Eniemooo/Sensor-HAT/docs/Sensor-HAT-3D-bottom.png

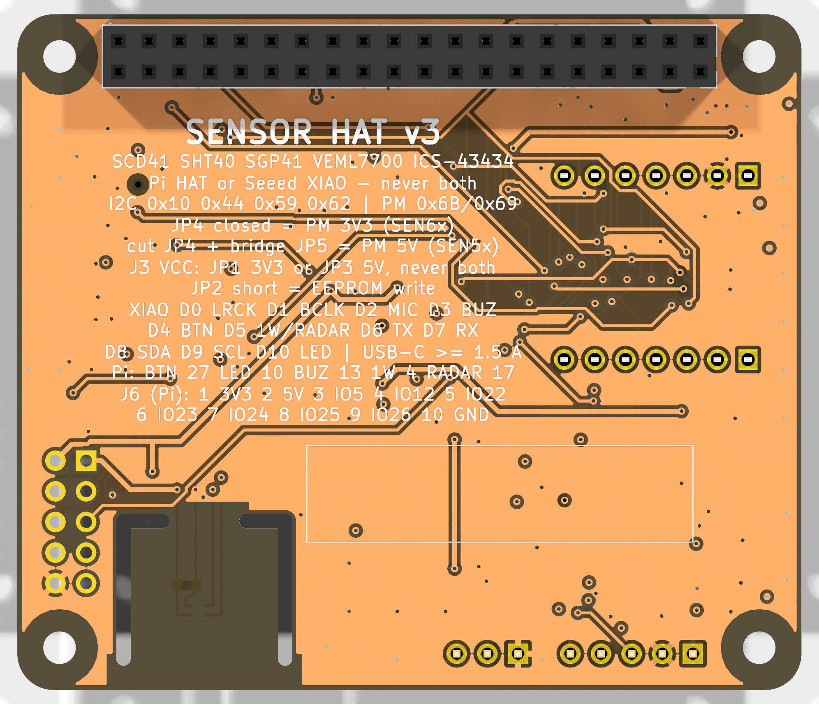
docs/Sensor-HAT-3D-bottom.png
