Eniemooo/Sensor-HAT/docs/Sensor-HAT-3D-top.png

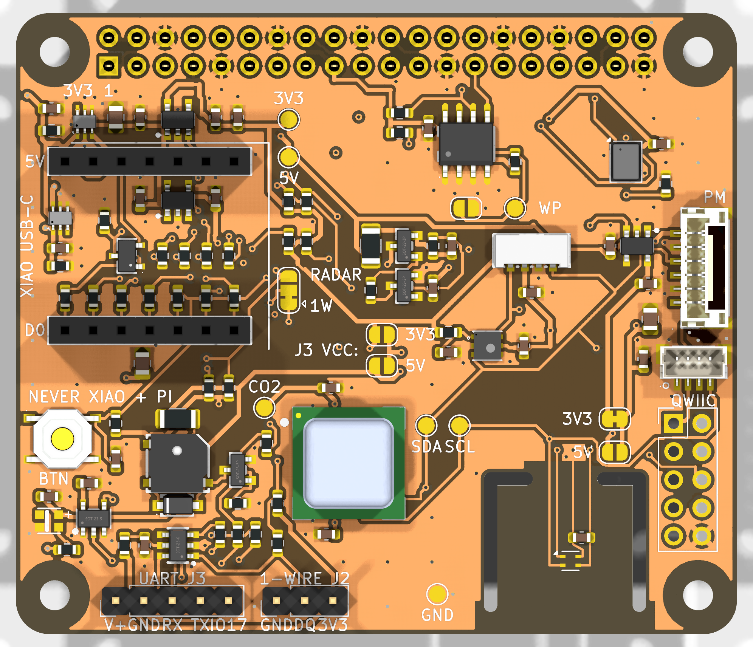
docs/Sensor-HAT-3D-top.png
