Eniemooo/Sensor-HAT/production/Sensor-HAT-BOM-jlcpcb-komplett.csv

Comment | Designator | Footprint | LCSC Part # | Quantity | Manufacturer | MPN
AP2112K-3.3 | U5,U6,U9 | SOT-25-5_L2.9-W1.6-P0.95-LS2.8-BL | C51118 | 3 | Diodes | AP2112K-3.3TRG1
10uF 25V | C11,C12 | C_0805_2012Metric | C15850 | 2 | Samsung | CL21A106KAYNNNE
1uF | C1,C2,C3,C14,C15,C17,C18,C27,C28,C29,C30,C31 | C_0603_1608Metric | C15849 | 12 | Samsung | CL10A105KB8NNNC
10uF | C4,C13 | C_0603_1608Metric | C19702 | 2 | Samsung | CL10A106KP8NNNC
BAV70 | D3 | SOT-23-3_L3.0-W1.7-P0.95-LS2.9-BR | C68978 | 1 | CJ | BAV70
LM66100 | U14,U15 | SC-70-6_L2.0-W1.3-P0.65-LS2.1-BL | C2869734 | 2 | TI | LM66100DCKR
100k | R4,R7,R11,R13,R14,R23,R29,R30,R32 | R_0603_1608Metric | C25803 | 9 | UNI-ROYAL | 0603WAF1003T5E
SCD41-D-R2 | U1 | LGA-20_L10.1-W10.1-P1.25-TL_SCD41-D-R2 | C3659294 | 1 | Sensirion | SCD41-D-R2
100nF | C5,C6,C8,C9,C10,C16,C20,C23,C24,C26 | C_0603_1608Metric | C14663 | 10 | YAGEO | CC0603KRX7R9BB104
SHT40 | U2 | SHT4x_DFN-4_1.5x1.5mm_P0.8mm_NoCentralPad | C2909890 | 1 | Sensirion | SHT40-AD1B-R2
SGP41 | U13 | DFN-6_L2.4-W2.4-P0.80-TL-EP | C3659325 | 1 | Sensirion | SGP41-D-R4
4.7 | R28 | R_0603_1608Metric | C23164 | 1 | UNI-ROYAL | 0603WAF470KT5E
VEML7700-TT | U7 | SENSOR-SMD_EML7700-TT | C1850416 | 1 | Vishay | VEML7700-TT
ICS-43434 | U3 | InvenSense_ICS-43434-6_3.5x2.65mm | C5656610 | 1 | TDK InvenSense | ICS-43434
CAT24C32 | U4 | SOIC-8_L5.0-W4.0-P1.27-LS6.0-BL | C81193 | 1 | onsemi | CAT24C32WI-GT3
3.9k | R2,R3 | R_0603_1608Metric | C23018 | 2 | UNI-ROYAL | 0603WAF3901T5E
1k | R5,R8,R9,R10 | R_0603_1608Metric | C21190 | 4 | UNI-ROYAL | 0603WAF1001T5E
1-Wire GND/DQ/3V3 | J2 | PinHeader_1x03_P2.54mm_Vertical | C49257 | 1 | BOOMELE | 2.54-1*3P
4.7k | R1,R26,R27 | R_0603_1608Metric | C23162 | 3 | UNI-ROYAL | 0603WAF4701T5E
100 | R16,R20,R22,R33,R34,R35,R36,R37,R38,R39,R40,R41,R42,R43 | R_0603_1608Metric | C22775 | 14 | UNI-ROYAL | 0603WAF1000T5E
UART (e.g. PMS5003) | J3 | PinHeader_1x05_P2.54mm_Vertical | C32713271 | 1 | hanxia | HX PZ2.54-1x5P ZZ
10k | R12,R15,R19,R31 | R_0603_1608Metric | C25804 | 4 | UNI-ROYAL | 0603WAF1002T5E
SRV05-4 | U8 | SOT-23-6_L2.9-W1.6-P0.95-LS2.8-BR | C85364 | 1 | ProTek Devices | SRV05-4-P-T7
0.5A PTC | F1 | Fuse_1206_3216Metric | C70077 | 1 | TECHFUSE | nSMD050-33V
AO3401A | Q1 | SOT-23_L2.9-W1.3-P1.90-LS2.4-BR | C15127 | 1 | Alpha & Omega | AO3401A
AO3400A | Q2,Q3 | SOT-23_L2.9-W1.3-P1.90-LS2.4-BR | C20917 | 2 | Alpha & Omega | AO3400A
22uF 25V | C19 | C_0805_2012Metric | C45783 | 1 | Samsung | CL21A226MAQNNNE
PM sensor (SEN6x/SEN5x) | J4 | CONN-SMD_6P-P1.25_BM06B-GHS-TBT-LF-SN-N | C189892 | 1 | JST | BM06B-GHS-TBT(LF)(SN)
Qwiic / STEMMA QT | J5 | CONN-SMD_BM04B-SRSS-TB | C160390 | 1 | JST | BM04B-SRSS-TB(LF)(SN)
Button | SW1 | SW-SMD_4P-L5.1-W5.1-P3.70-LS6.5-TL_H1.5 | C318884 | 1 | XKB | TS-1187A-B-A-B
74LV1T125 | U12 | SOT-23-5_L3.0-W1.7-P0.95-LS2.8-BL | C473338 | 1 | TI | SN74LV1T125DBVR
WS2812B-2020 | D1 | LED-SMD_4P-L2.2-W2.0-P1.00_WS2815C-2020-4P | C52917434 | 1 | Worldsemi | WS2812B-2020-V6
MLT-5020 4kHz | LS1 | BUZ-SMD_L5.0-W5.5-P4.60 | C94598 | 1 | Huaneng | MLT-5020
33 0.5W 1206 | R21 | R_1206_3216Metric | C5713420 | 1 | FOJAN | FRP1206F33R0TS
1N4148W | D2 | SOD-123F_L2.7-W1.6-LS3.8-RD | C81598 | 1 | ST | 1N4148W
XIAO D0-D6 | J7,J8 | HDR-TH_7P-P2.54-V-F | C2897370 | 2 | HCTL | PM254-1-07-Z-8.5
