Eniemooo/Sensor-HAT/docs/Sensor-HAT-Bestueckung-oben.pdf

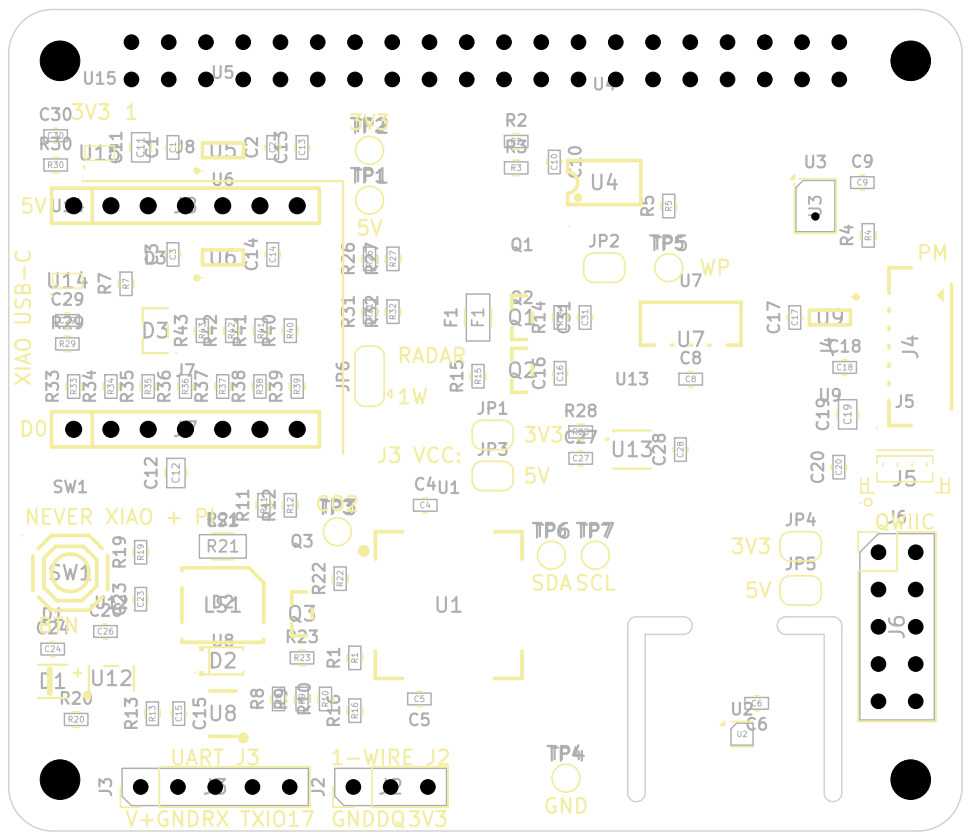
[picture p4: page 1]

Emanuel Bachmann
Sheet:
File: Sensor-HAT.kicad_pcb
Title: Sensor HAT v3 Universal (for Raspberry Pi or Seeed XIAO)

Size: A3 | Rev: 3.0 | F Date: 2026-10-22
KiCad E.D.A. 10.0.7 | Id: 1/1
