Eniemooo/Sensor-HAT/docs/Sensor-HAT-Bestueckung-unten.pdf

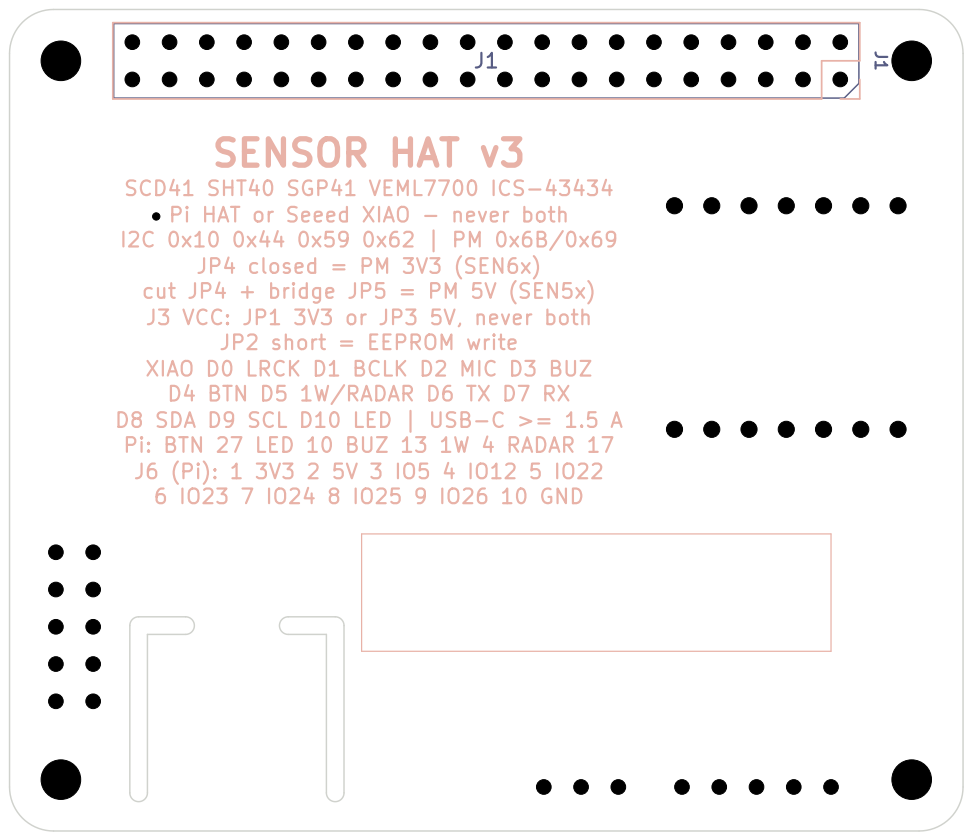
[picture p5: page 1]

6 IO23 7 IO24 8 IO25 9 IO26 10 GND SENSOR HAT v3
SCD41 SHT40 SGP41 VEML7700 ICS-43434 Pi HAT or Seeed XIAO - never both

JP4 closed = PM 3V3 (SEN6x) cut JP4 + bridge JP5 = PM 5V (SEN5x) J3 VCC: JP1 3V3 or JP3 5V, never both

JP2 short = EEPROM write XIAO D0 LRCK D1 BCLK D2 MIC D3 BUZ D4 BTN D5 1W/RADAR D6 TX D7 RX D8 SDA D9 SCL D10 LED | USB-C >= 1.5 A Pi: BTN 27 LED 10 BUZ 13 1W 4 RADAR 17

Sheet:
File: Sensor-HAT.kicad_pcb
Title: Sensor HAT v3 Universal (for Raspberry Pi or Seeed XIAO)

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
