Eniemooo/Sensor-HAT/docs/Sensor-HAT-Schaltplan.pdf

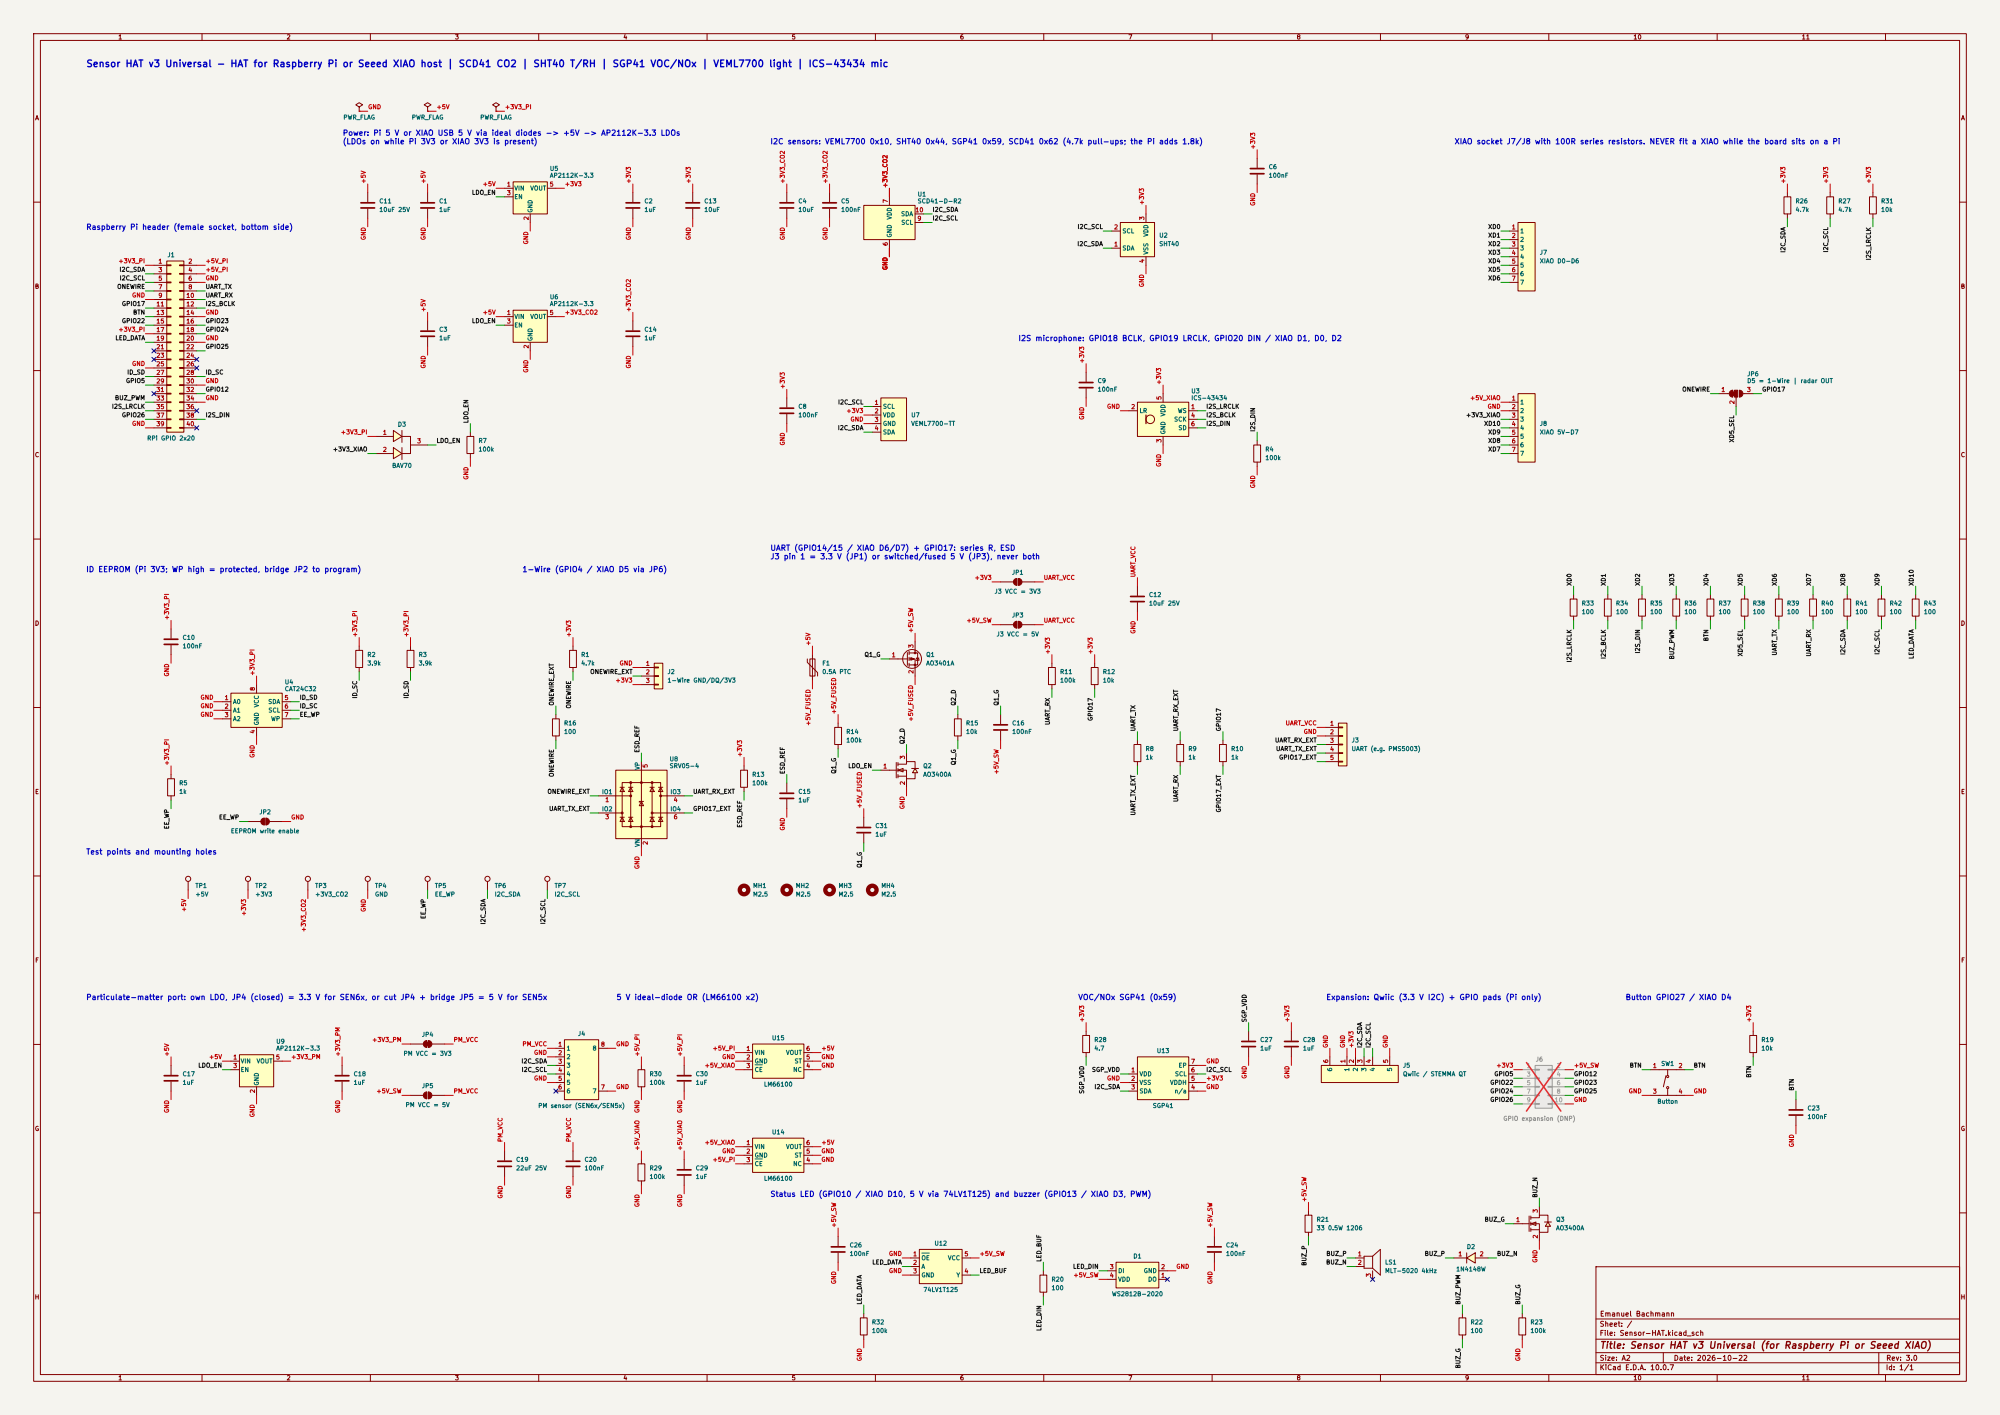
[picture p6: page 1]

Sensor HAT v3 Universal - HAT for Raspberry Pi or Seeed XIAO host | SCD41 CO2 | SHT40 T/RH | SGP41 VOC/NOx | VEML7700 light | ICS-43434 mic

Power: Pi 5 V or XIAO USB 5 V via ideal diodes -> +5V -> AP2112K-3.3 LDOs
(LDOs on while Pi 3V3 or XIAO 3V3 is present)

Raspberry Pi header (female socket, bottom side)
J1 RPi GPIO 2x20

I2S microphone: GPIO18 BCLK, GPIO19 LRCLK, GPIO20 DIN / XIAO D1, D0, D2

UART (GPIO14/15 / XIAO D6/D7) + GPIO17: series R, ESD
J3 pin 1 = 3.3 V (JP1) or switched/fused 5 V (JP3), never both

ID EEPROM (Pi 3V3; WP high = protected, bridge JP2 to program)

Test points and mounting holes

Expansion: Qwiic (3.3 V I2C) + GPIO pads (Pi only)

Status LED (GPIO10 / XIAO D10, 5 V via 74LV1T125) and buzzer (GPIO13 / XIAO D3, PWM)

Emanuel Bachmann
Sheet: /
File: Sensor-HAT.kicad_sch
Title: Sensor HAT v3 Universal (for Raspberry Pi or Seeed XIAO)

Size: A2 | Rev: 3.0
KiCad E.D.A. 10.0.7 | Id: 1/1
