Eniemooo/Sensor-HAT/Sensor-HAT.kicad_pcb

## KiCad design Sensor-HAT.kicad_pcb (2026-10-27)

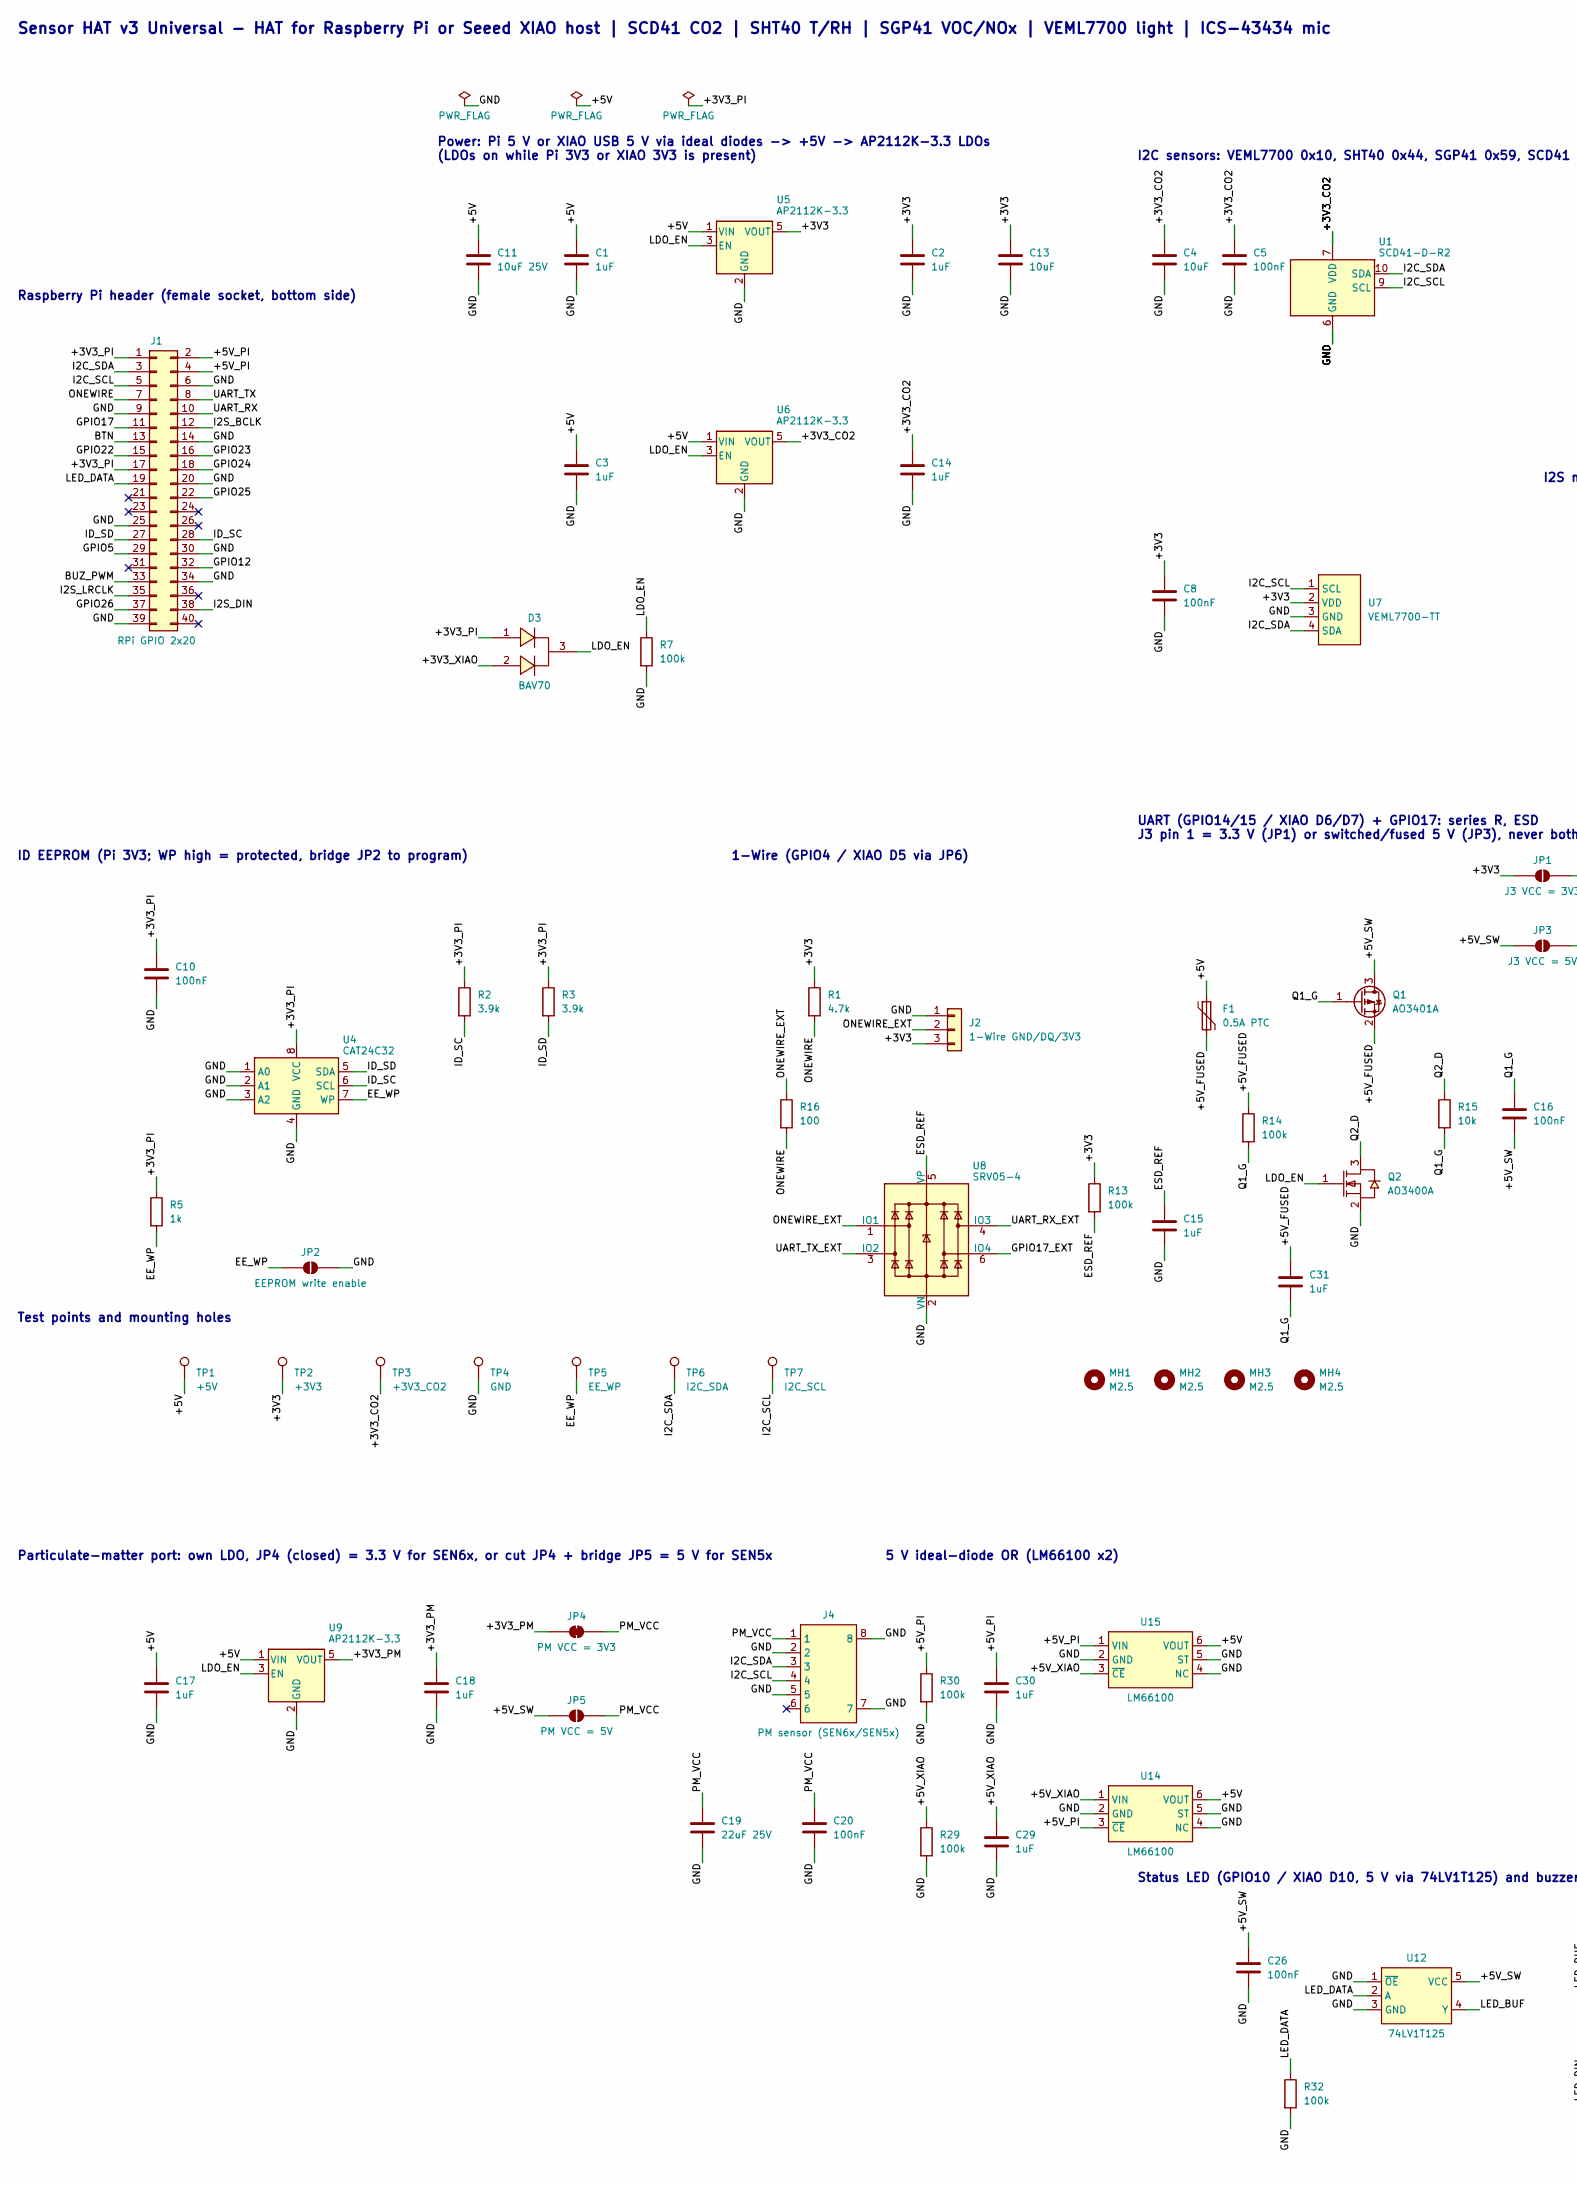
[picture p7: schematic Sensor-HAT.kicad_sch, Sensor HAT v3 Universal (for Raspberry Pi or Seeed XIAO), part in row 1, column 1]

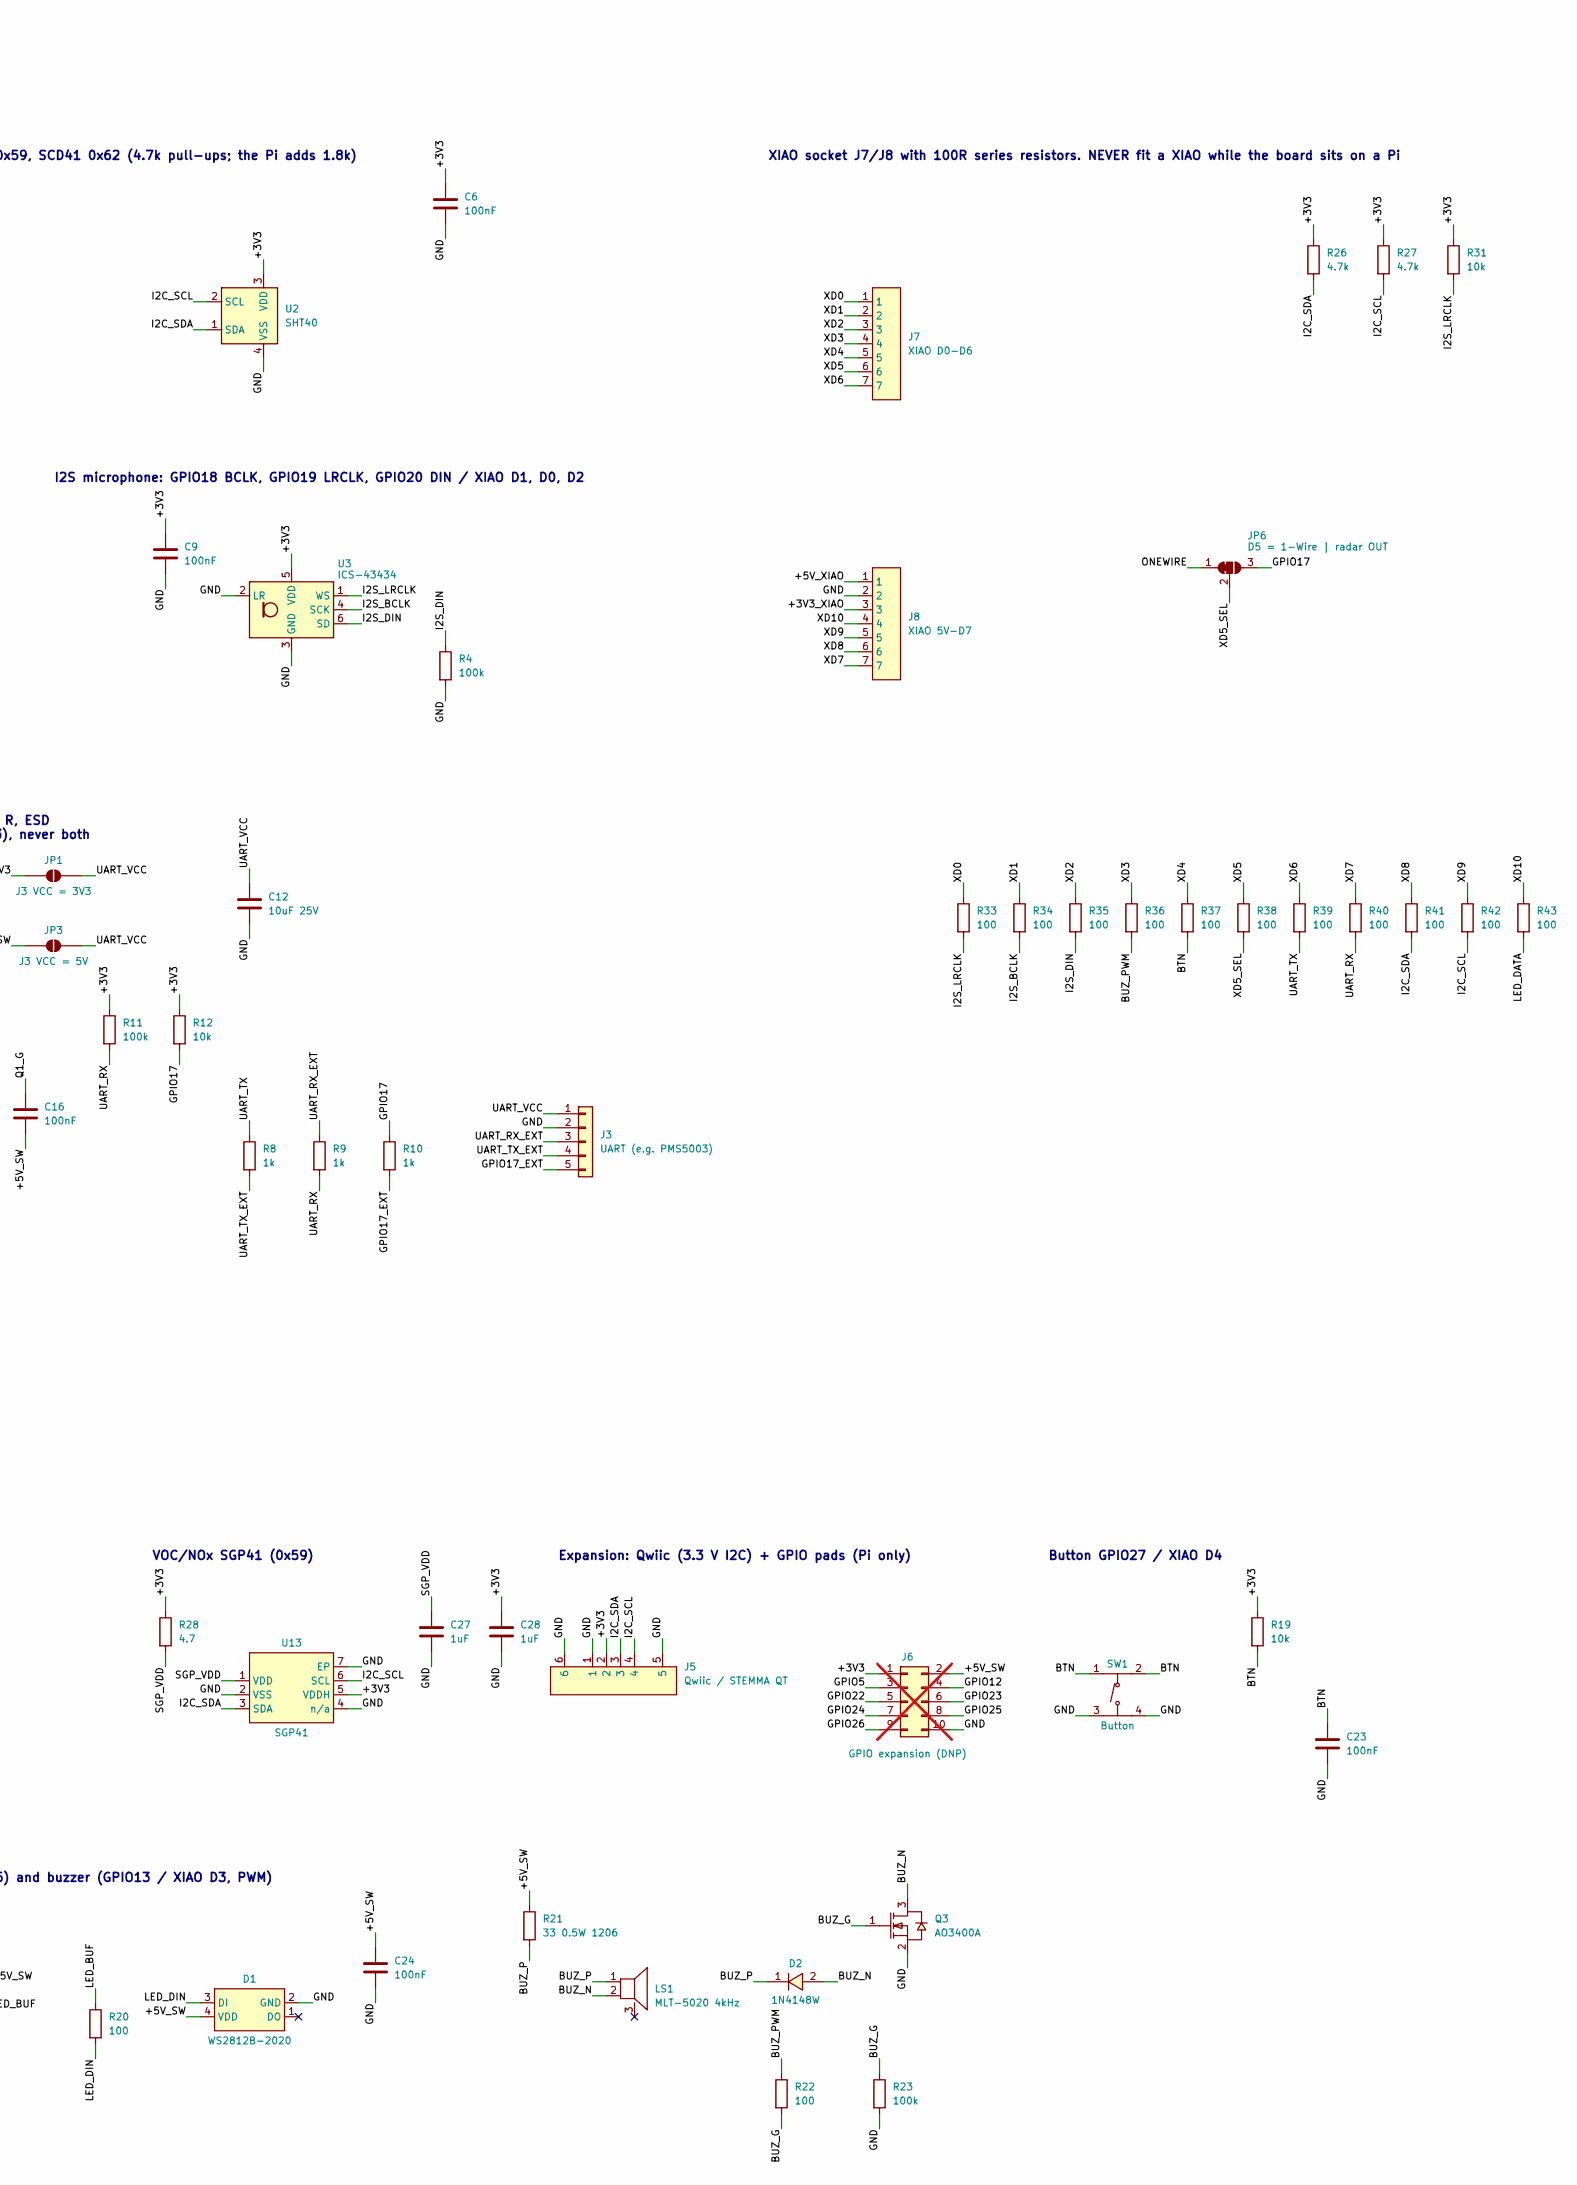
[picture p8: schematic Sensor-HAT.kicad_sch, Sensor HAT v3 Universal (for Raspberry Pi or Seeed XIAO), part in row 1, column 2]

Parts:
C1, C2, C3, C14, C15, C17, C18, C27, C28, C29, C30, C31: 1uF; C_0603_1608Metric; MPN CL10A105KB8NNNC; LCSC C15849
C4, C13: 10uF; C_0603_1608Metric; MPN CL10A106KP8NNNC; LCSC C19702
C5, C6, C8, C9, C10, C16, C20, C23, C24, C26: 100nF; C_0603_1608Metric; MPN CC0603KRX7R9BB104; LCSC C14663
C11, C12: 10uF 25V; C_0805_2012Metric; MPN CL21A106KAYNNNE; LCSC C15850
C19: 22uF 25V; C_0805_2012Metric; MPN CL21A226MAQNNNE; LCSC C45783
D1: WS2812B-2020; LED-SMD_4P-L2.2-W2.0-P1.00_WS2815C-2020-4P; MPN WS2812B-2020-V6; LCSC C52917434
D2: 1N4148W; SOD-123F_L2.7-W1.6-LS3.8-RD; MPN 1N4148W; LCSC C81598
D3: BAV70; SOT-23-3_L3.0-W1.7-P0.95-LS2.9-BR; MPN BAV70; LCSC C68978
F1: 0.5A PTC; Fuse_1206_3216Metric; MPN nSMD050-33V; LCSC C70077
J1: RPi GPIO 2x20; PinSocket_2x20_P2.54mm_Vertical; MPN 2.54-2*20; LCSC C2977589
J2: 1-Wire GND/DQ/3V3; PinHeader_1x03_P2.54mm_Vertical; MPN 2.54-1*3P; LCSC C49257
J3: UART (e.g. PMS5003); PinHeader_1x05_P2.54mm_Vertical; MPN HX PZ2.54-1x5P ZZ; LCSC C32713271
J4: PM sensor (SEN6x/SEN5x); CONN-SMD_6P-P1.25_BM06B-GHS-TBT-LF-SN-N; MPN BM06B-GHS-TBT(LF)(SN); LCSC C189892
J5: Qwiic / STEMMA QT; CONN-SMD_BM04B-SRSS-TB; MPN BM04B-SRSS-TB(LF)(SN); LCSC C160390
J6: GPIO expansion (DNP); PinHeader_2x05_P2.54mm_Vertical; not fitted
J7: XIAO D0-D6; HDR-TH_7P-P2.54-V-F; MPN PM254-1-07-Z-8.5; LCSC C2897370
J8: XIAO 5V-D7; HDR-TH_7P-P2.54-V-F; MPN PM254-1-07-Z-8.5; LCSC C2897370
JP1: J3 VCC = 3V3; SolderJumper-2_P1.3mm_Open_RoundedPad1.0x1.5mm
JP2: EEPROM write enable; SolderJumper-2_P1.3mm_Open_RoundedPad1.0x1.5mm
JP3: J3 VCC = 5V; SolderJumper-2_P1.3mm_Open_RoundedPad1.0x1.5mm
JP4: PM VCC = 3V3; SolderJumper-2_P1.3mm_Bridged_RoundedPad1.0x1.5mm
JP5: PM VCC = 5V; SolderJumper-2_P1.3mm_Open_RoundedPad1.0x1.5mm
JP6: D5 = 1-Wire | radar OUT; SolderJumper-3_P1.3mm_Bridged12_RoundedPad1.0x1.5mm
LS1: MLT-5020 4kHz; BUZ-SMD_L5.0-W5.5-P4.60; MPN MLT-5020; LCSC C94598
MH1, MH2, MH3, MH4: M2.5; MountingHole_2.7mm_M2.5
Q1: AO3401A; SOT-23_L2.9-W1.3-P1.90-LS2.4-BR; MPN AO3401A; LCSC C15127
Q2, Q3: AO3400A; SOT-23_L2.9-W1.3-P1.90-LS2.4-BR; MPN AO3400A; LCSC C20917
R1, R26, R27: 4.7k; R_0603_1608Metric; MPN 0603WAF4701T5E; LCSC C23162
R2, R3: 3.9k; R_0603_1608Metric; MPN 0603WAF3901T5E; LCSC C23018
R4, R7, R11, R13, R14, R23, R29, R30, R32: 100k; R_0603_1608Metric; MPN 0603WAF1003T5E; LCSC C25803
R5, R8, R9, R10: 1k; R_0603_1608Metric; MPN 0603WAF1001T5E; LCSC C21190
R12, R15, R19, R31: 10k; R_0603_1608Metric; MPN 0603WAF1002T5E; LCSC C25804
R16, R20, R22, R33, R34, R35, R36, R37, R38, R39, R40, R41, R42, R43: 100; R_0603_1608Metric; MPN 0603WAF1000T5E; LCSC C22775
R21: 33 0.5W 1206; R_1206_3216Metric; MPN FRP1206F33R0TS; LCSC C5713420
R28: 4.7; R_0603_1608Metric; MPN 0603WAF470KT5E; LCSC C23164
SW1: Button; SW-SMD_4P-L5.1-W5.1-P3.70-LS6.5-TL_H1.5; MPN TS-1187A-B-A-B; LCSC C318884
TP1: +5V; TestPoint_Pad_D1.5mm
TP2: +3V3; TestPoint_Pad_D1.5mm
TP3: +3V3_CO2; TestPoint_Pad_D1.5mm
TP4: GND; TestPoint_Pad_D1.5mm
TP5: EE_WP; TestPoint_Pad_D1.5mm
TP6: I2C_SDA; TestPoint_Pad_D1.5mm
TP7: I2C_SCL; TestPoint_Pad_D1.5mm
U1: SCD41-D-R2; LGA-20_L10.1-W10.1-P1.25-TL_SCD41-D-R2; MPN SCD41-D-R2; LCSC C3659294
U2: SHT40; SHT4x_DFN-4_1.5x1.5mm_P0.8mm_NoCentralPad; MPN SHT40-AD1B-R2; LCSC C2909890
U3: ICS-43434; InvenSense_ICS-43434-6_3.5x2.65mm; MPN ICS-43434; LCSC C5656610
U4: CAT24C32; SOIC-8_L5.0-W4.0-P1.27-LS6.0-BL; MPN CAT24C32WI-GT3; LCSC C81193
U5, U6, U9: AP2112K-3.3; SOT-25-5_L2.9-W1.6-P0.95-LS2.8-BL; MPN AP2112K-3.3TRG1; LCSC C51118
U7: VEML7700-TT; SENSOR-SMD_EML7700-TT; MPN VEML7700-TT; LCSC C1850416
U8: SRV05-4; SOT-23-6_L2.9-W1.6-P0.95-LS2.8-BR; MPN SRV05-4-P-T7; LCSC C85364
U12: 74LV1T125; SOT-23-5_L3.0-W1.7-P0.95-LS2.8-BL; MPN SN74LV1T125DBVR; LCSC C473338
U13: SGP41; DFN-6_L2.4-W2.4-P0.80-TL-EP; MPN SGP41-D-R4; LCSC C3659325
U14, U15: LM66100; SC-70-6_L2.0-W1.3-P0.65-LS2.1-BL; MPN LM66100DCKR; LCSC C2869734

Connections:
/+3V3: C2.1, C6.1, C8.1, C9.1, C13.1, C28.1, J2.3, J5.2, J6.1, JP1.1 (A), R1.1, R11.1, R12.1, R13.1, R19.1, R26.1, R27.1, R28.1, R31.1, TP2.1, U2.3 (VDD), U3.5 (VDD), U5.5 (VOUT), U7.2 (VDD), U13.5 (VDDH)
/+3V3_CO2: C4.1, C5.1, C14.1, TP3.1, U1.7 (VDD), U1.19 (VDD), U6.5 (VOUT)
/+3V3_PI: C10.1, D3.1, J1.1, J1.17, R2.1, R3.1, R5.1, U4.8 (VCC)
/+3V3_PM: C18.1, JP4.1 (A), U9.5 (VOUT)
/+3V3_XIAO: D3.2, J8.3
/+5V: C1.1, C3.1, C11.1, C17.1, F1.1, TP1.1, U5.1 (VIN), U6.1 (VIN), U9.1 (VIN), U14.6 (VOUT), U15.6 (VOUT)
/+5V_FUSED: C31.1, F1.2, Q1.2 (S), R14.1
/+5V_PI: C30.1, J1.2, J1.4, R30.1, U14.3 (~CE), U15.1 (VIN)
/+5V_SW: C16.2, C24.1, C26.1, D1.4 (VDD), J6.2, JP3.1 (A), JP5.1 (A), Q1.3 (D), R21.1, U12.5 (VCC)
/+5V_XIAO: C29.1, J8.1, R29.1, U14.1 (VIN), U15.3 (~CE)
/BTN: C23.1, J1.13, R19.2, R37.2, SW1.1 (A), SW1.2 (B)
/BUZ_G: Q3.1 (G), R22.2, R23.1
/BUZ_N: D2.2 (A), LS1.2 (-), Q3.3 (D)
/BUZ_P: D2.1 (K), LS1.1 (+), R21.2
/BUZ_PWM: J1.33, R22.1, R36.2
/EE_WP: JP2.1 (A), R5.2, TP5.1, U4.7 (WP)
/ESD_REF: C15.1, R13.2, U8.5 (VP)
/GND: C1.2, C2.2, C3.2, C4.2, C5.2, C6.2, C8.2, C9.2, C10.2, C11.2, C12.2, C13.2, C14.2, C15.2, C17.2, C18.2, C19.2, C20.2, C23.2, C24.2, C26.2, C27.2, C28.2, C29.2, C30.2, D1.2 (GND), J1.6, J1.9, J1.14, J1.20, J1.25, J1.30, J1.34, J1.39, J2.1, J3.2, J4.2, J4.5, J4.7, J4.8, J5.1, J5.5, J5.6, J6.10, J8.2, JP2.2 (B), Q2.2 (S), Q3.2 (S), R4.2, R7.2, R23.2, R29.2, R30.2, R32.2, SW1.3 (C), SW1.4 (D), TP4.1, U1.6 (GND), U1.20 (GND), U1.21 (GND), U2.4 (VSS), U3.2 (LR), U3.3 (GND), U4.1 (A0), U4.2 (A1), U4.3 (A2), U4.4 (GND), U5.2 (GND), U6.2 (GND), U7.3 (GND), U8.2 (VN), U9.2 (GND), U12.1 (~OE), U12.3 (GND), U13.2 (VSS), U13.4 (n/a), U13.7 (EP), U14.2 (GND), U14.4 (NC), U14.5 (ST), U15.2 (GND), U15.4 (NC), U15.5 (ST)
/GPIO5: J1.29, J6.3
/GPIO12: J1.32, J6.4
/GPIO17: J1.11, JP6.3 (B), R10.1, R12.2
/GPIO17_EXT: J3.5, R10.2, U8.6 (IO4)
/GPIO22: J1.15, J6.5
/GPIO23: J1.16, J6.6
/GPIO24: J1.18, J6.7
/GPIO25: J1.22, J6.8
/GPIO26: J1.37, J6.9
/I2C_SCL: J1.5, J4.4, J5.4, R27.2, R42.2, TP7.1, U1.9 (SCL), U2.2 (SCL), U7.1 (SCL), U13.6 (SCL)
/I2C_SDA: J1.3, J4.3, J5.3, R26.2, R41.2, TP6.1, U1.10 (SDA), U2.1 (SDA), U7.4 (SDA), U13.3 (SDA)
/I2S_BCLK: J1.12, R34.2, U3.4 (SCK)
/I2S_DIN: J1.38, R4.1, R35.2, U3.6 (SD)
/I2S_LRCLK: J1.35, R31.2, R33.2, U3.1 (WS)
/ID_SC: J1.28, R2.2, U4.6 (SCL)
/ID_SD: J1.27, R3.2, U4.5 (SDA)
/LDO_EN: D3.3, Q2.1 (G), R7.1, U5.3 (EN), U6.3 (EN), U9.3 (EN)
/LED_BUF: R20.1, U12.4 (Y)
/LED_DATA: J1.19, R32.1, R43.2, U12.2 (A)
/LED_DIN: D1.3 (DI), R20.2
/ONEWIRE: J1.7, JP6.1 (A), R1.2, R16.2
/ONEWIRE_EXT: J2.2, R16.1, U8.1 (IO1)
/PM_VCC: C19.1, C20.1, J4.1, JP4.2 (B), JP5.2 (B)
/Q1_G: C16.1, C31.2, Q1.1 (G), R14.2, R15.2
/Q2_D: Q2.3 (D), R15.1
/SGP_VDD: C27.1, R28.2, U13.1 (VDD)
/UART_RX: J1.10, R9.2, R11.2, R40.2
/UART_RX_EXT: J3.3, R9.1, U8.4 (IO3)
/UART_TX: J1.8, R8.1, R39.2
/UART_TX_EXT: J3.4, R8.2, U8.3 (IO2)
/UART_VCC: C12.1, J3.1, JP1.2 (B), JP3.2 (B)
/XD0: J7.1, R33.1
/XD1: J7.2, R34.1
/XD2: J7.3, R35.1
/XD3: J7.4, R36.1
/XD4: J7.5, R37.1
/XD5: J7.6, R38.1
/XD5_SEL: JP6.2 (C), R38.2
/XD6: J7.7, R39.1
/XD7: J8.7, R40.1
/XD8: J8.6, R41.1
/XD9: J8.5, R42.1
/XD10: J8.4, R43.1

Notes on the sheet:
Sensor HAT v3 Universal - HAT for Raspberry Pi or Seeed XIAO host | SCD41 CO2 | SHT40 T/RH | SGP41 VOC/NOx | VEML7700 light | ICS-43434 mic
Raspberry Pi header (female socket, bottom side)
Power: Pi 5 V or XIAO USB 5 V via ideal diodes -> +5V -> AP2112K-3.3 LDOs
(LDOs on while Pi 3V3 or XIAO 3V3 is present)
I2C sensors: VEML7700 0x10, SHT40 0x44, SGP41 0x59, SCD41 0x62 (4.7k pull-ups; the Pi adds 1.8k)
I2S microphone: GPIO18 BCLK, GPIO19 LRCLK, GPIO20 DIN / XIAO D1, D0, D2
XIAO socket J7/J8 with 100R series resistors. NEVER fit a XIAO while the board sits on a Pi
ID EEPROM (Pi 3V3; WP high = protected, bridge JP2 to program)
1-Wire (GPIO4 / XIAO D5 via JP6)
UART (GPIO14/15 / XIAO D6/D7) + GPIO17: series R, ESD
J3 pin 1 = 3.3 V (JP1) or switched/fused 5 V (JP3), never both
Test points and mounting holes
Particulate-matter port: own LDO, JP4 (closed) = 3.3 V for SEN6x, or cut JP4 + bridge JP5 = 5 V for SEN5x
5 V ideal-diode OR (LM66100 x2)
VOC/NOx SGP41 (0x59)
Expansion: Qwiic (3.3 V I2C) + GPIO pads (Pi only)
Button GPIO27 / XIAO D4
Status LED (GPIO10 / XIAO D10, 5 V via 74LV1T125) and buzzer (GPIO13 / XIAO D3, PWM)

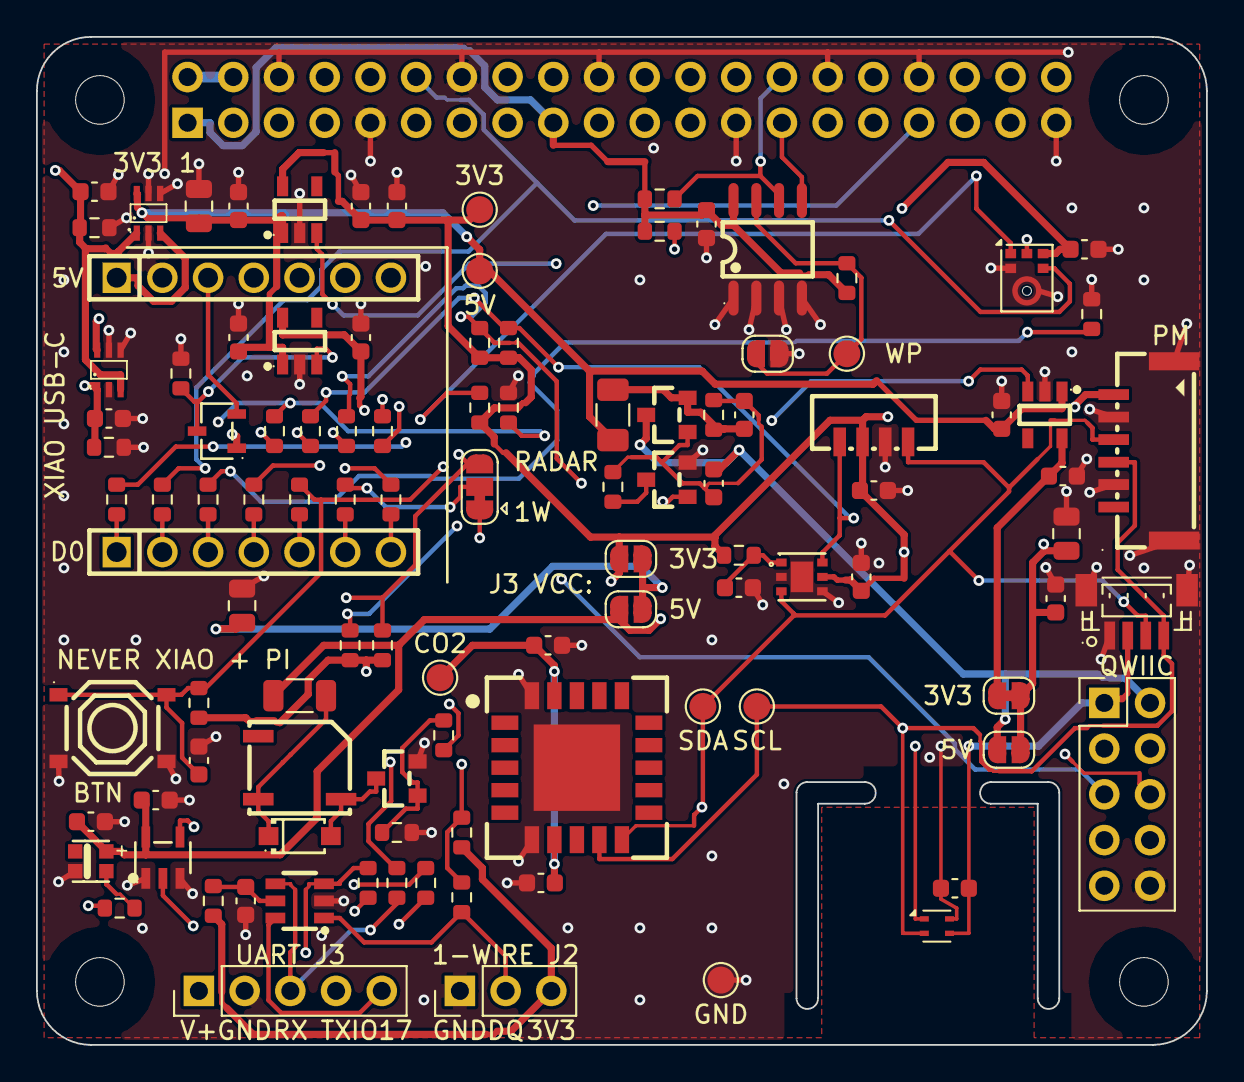
[picture p9: board Sensor-HAT.kicad_pcb from above]

Board: 4 copper layers, 65.0 x 56.0 mm, 112 parts (1 on the bottom side), 61 nets.
