Eniemooo/Sensor-HAT/(commit log)

2026-10-22 Sensor HAT v3 "Universal": initial public version
    Open-hardware indoor sensor board (KiCad 10, 65 x 56 mm, 4 layers) that runs
    either as a HAT for Raspberry Pi or standalone with a Seeed XIAO ESP32-S3/C3/C6
    (ESPHome). SCD41 CO2, SHT40 T/RH, SGP41 VOC/NOx, VEML7700 light, ICS-43434
    sound level, RGB LED, button, buzzer, ports for SEN6x/SEN5x, radar, 1-Wire
    and Qwiic. ERC and DRC clean; not yet tested in hardware.
    - KiCad project, generator scripts, JLCPCB production files, PDFs, renders
    - ESPHome configs (API encryption, hotspot password) and Pi test script
    - Licences: CERN-OHL-S-2.0 (hardware), MIT (software), CC-BY-SA-4.0 or
    CERN-OHL-S-2.0 (docs); REUSE 3.3 compliant, third-party notes in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
    [Sensor-HAT-BOM-handloeten.csv, Sensor-HAT-BOM-jlcpcb-komplett.csv, Sensor-HAT-BOM-jlcpcb.csv, Sensor-HAT.kicad_pcb, Sensor-HAT.kicad_sch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]
2026-10-22 Tidy up the schematic: no overlapping texts (no electrical change)
    - gen_sch.py places reference/value beside the body, above/below or above
    the top-right corner, depending on where the pins leave, so they no longer
    cross wires and labels; PWR_FLAG labels get a short stub
    - design.py: XIAO series resistors R33-R43 in one row, crowded parts moved
    apart, long header texts split into two lines
    - patch_lib.py hides pin names that the EasyEDA symbols draw over their
    graphics and removes the pin-1 dots
    - schematic PDF re-exported
    Netlist identical (74 nets, 112 parts), ERC 0, DRC 0 with schematic parity.
    [Sensor-HAT.kicad_sch]
2026-10-27 Add AISLER logo placeholder and sponsor credit
    AISLER sponsors the prototype PCBs. Their logo replacement placeholder
    (32 x 8 mm rectangle of four 3.3 mil lines) sits on the bottom silkscreen
    below the legend, clear of pads, holes and the sensor-island slot. It is
    defined in placement.py and drawn by gen_pcb.py, and was added to the routed
    board without touching anything else.
    Only the bottom silkscreen Gerber changes; copper, drill, mask, paste, BOM and
    CPL are identical. DRC 0 with schematic parity. README, README.de, NOTICE and
    CHANGELOG credit AISLER.
    [Sensor-HAT.kicad_pcb]
2026-10-30 Remove the AISLER sponsor note from the READMEs
    The prototypes will not be made under the planned AISLER sponsorship.
    The logo frame on the bottom silkscreen stays for now (see CHANGELOG).
